shybovycha/adjika-guitar-preamp/tomato-preamp.kicad_pcb

## KiCad design tomato-preamp.kicad_pcb (2026-06-26)

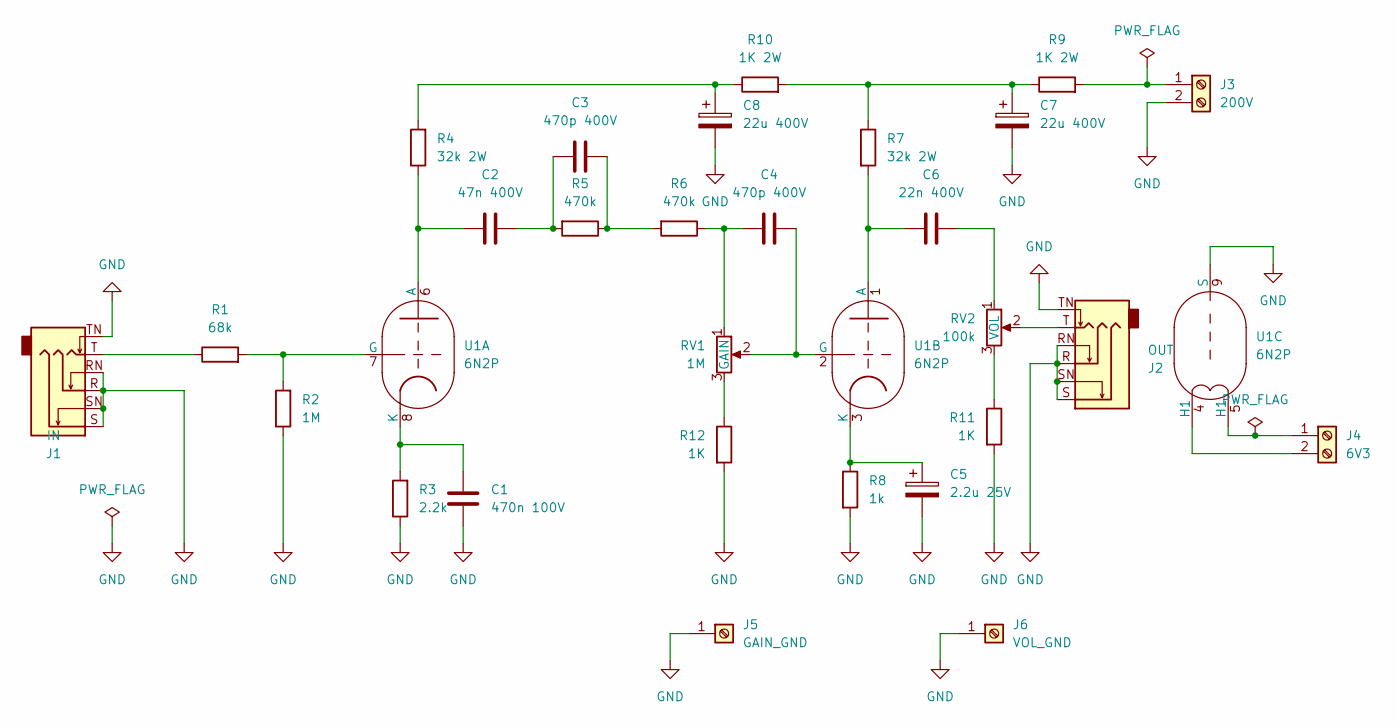
[picture p7: schematic tomato-preamp.kicad_sch, "Adjika" guitar preamp]

Parts:
C1: 470n 100V; C_Rect_L7.2mm_W5.0mm_P5.00mm
C2: 47n 400V; C_Rect_L11.0mm_W5.1mm_P10.00mm_MKT
C3, C4: 470p 400V; C_Rect_L7.0mm_W3.5mm_P5.00mm
C5: 2.2u 25V; CP_Radial_D5.0mm_P2.50mm
C6: 22n 400V; C_Rect_L11.0mm_W4.2mm_P10.00mm_MKT
C7, C8: 22u 400V; CP_Radial_D13.0mm_P5.00mm
J1: IN; Jack_6.35mm_Neutrik_NMJ6HFD2-AU_Horizontal
J2: OUT; Jack_6.35mm_Neutrik_NMJ6HFD2-AU_Horizontal
J3: 200V; SolderWire-0.75sqmm_1x02_P7mm_D1.25mm_OD3.5mm
J4: 6V3; SolderWire-0.75sqmm_1x02_P7mm_D1.25mm_OD3.5mm
J5: GAIN_GND; SolderWire-0.127sqmm_1x01_D0.48mm_OD1mm
J6: VOL_GND; SolderWire-0.127sqmm_1x01_D0.48mm_OD1mm
R1: 68k; R_Axial_DIN0207_L6.3mm_D2.5mm_P10.16mm_Horizontal
R2: 1M; R_Axial_DIN0207_L6.3mm_D2.5mm_P10.16mm_Horizontal
R3: 2.2k; R_Axial_DIN0207_L6.3mm_D2.5mm_P10.16mm_Horizontal
R4, R7: 32k 2W; R_Axial_DIN0516_L15.5mm_D5.0mm_P20.32mm_Horizontal
R5, R6: 470k; R_Axial_DIN0207_L6.3mm_D2.5mm_P10.16mm_Horizontal
R8: 1k; R_Axial_DIN0207_L6.3mm_D2.5mm_P10.16mm_Horizontal
R9, R10: 1K 2W; R_Axial_DIN0516_L15.5mm_D5.0mm_P20.32mm_Horizontal
R11, R12: 1K; R_Axial_DIN0207_L6.3mm_D2.5mm_P10.16mm_Horizontal
RV1: 1M; Potentiometer_Alps_RK163_Single_Horizontal
RV2: 100k; Potentiometer_Alps_RK163_Single_Horizontal
U1: 6N2P; Valve_6N2P-3

Connections:
GND: C1.2, C5.2, C7.2, C8.2, J1.R, J1.RN, J1.S, J1.SN, J1.TN, J2.R, J2.RN, J2.S, J2.SN, J2.TN, J3.2, J5.1 (Pin_1_1), J6.1 (Pin_1_1), R2.1, R3.1, R8.2, R11.2, R12.2, U1.9 (S)
unnamed: C2.2, C3.1, R5.2
unnamed: C3.2, R5.1, R6.2
unnamed: C4.1, R6.1, RV1.1
unnamed: C6.2, RV2.1
unnamed: C7.1, R7.1, R9.1, R10.2
unnamed: C8.1, R4.2, R10.1
unnamed: J1.T, R1.1
unnamed: J2.T, RV2.2
unnamed: J3.1, R9.2
unnamed: J4.1, U1.5 (H1)
unnamed: J4.2, U1.4 (H1)
unnamed: R11.1, RV2.3
unnamed: R12.1, RV1.3
unnamed: C2.1, R4.1, U1.6 (A)
unnamed: R1.2, R2.2, U1.7 (G)
unnamed: C1.1, R3.2, U1.8 (K)
unnamed: C6.1, R7.2, U1.1 (A)
unnamed: C4.2, RV1.2, U1.2 (G)
unnamed: C5.1, R8.1, U1.3 (K)

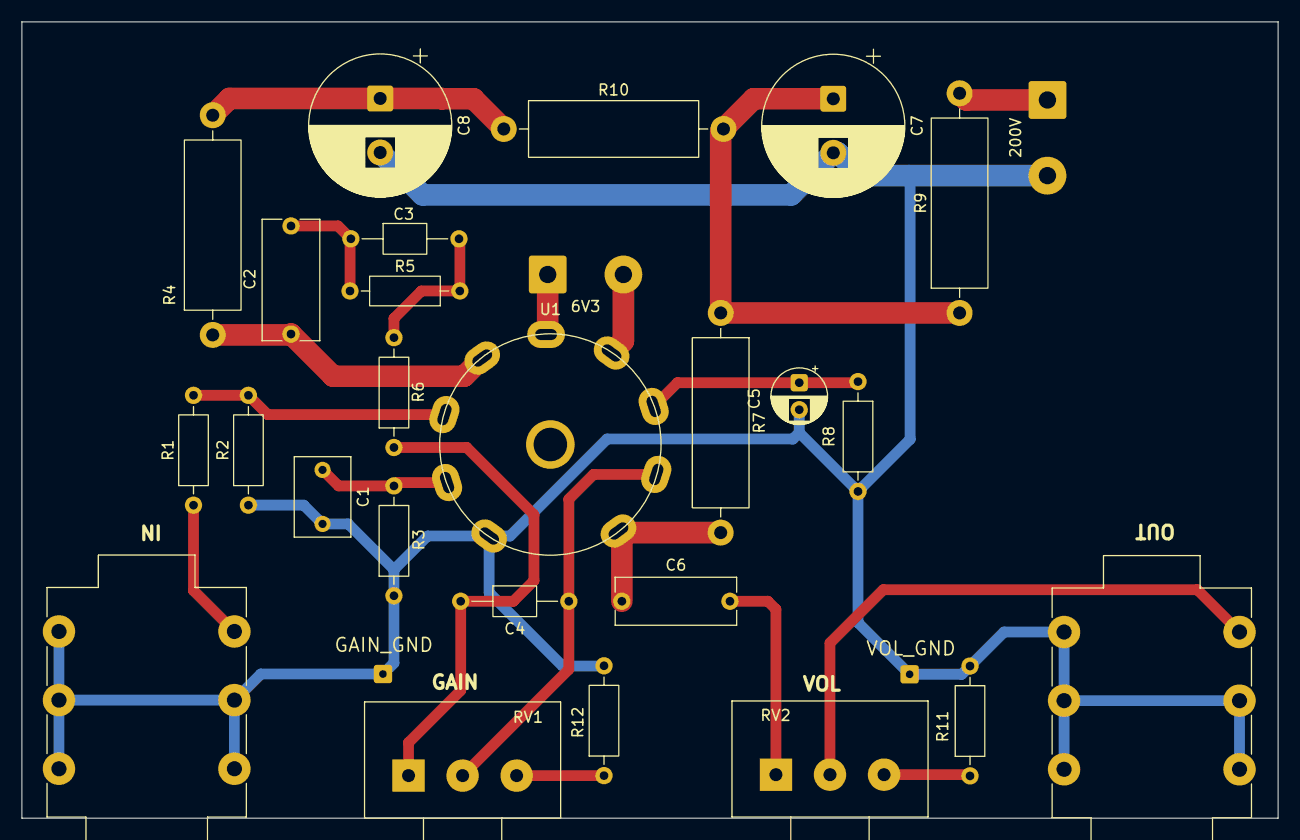
[picture p8: board tomato-preamp.kicad_pcb from above]

Board: 2 copper layers, 116.2 x 73.7 mm, 29 parts (0 on the bottom side), 20 nets.
