shybovycha/adjika-guitar-preamp/(commit log)

2026-02-13 Initial design
    [tomato-preamp.kicad_pcb, tomato-preamp.kicad_sch]
2026-02-13 single-layer version
    [tomato-preamp.kicad_pcb]
2026-02-13 moving potentiometers to the equidistant places
    [tomato-preamp.kicad_pcb]
2026-02-13 shorten the traces
    [tomato-preamp.kicad_pcb]
2026-02-13 a slightly refined board
    [tomato-preamp.kicad_pcb, tomato-preamp.kicad_sch]
2026-02-13 update CBB capacitors footprints
    [tomato-preamp.kicad_pcb, tomato-preamp.kicad_sch]
2026-02-26 Update footprints
    [tomato-preamp.kicad_pcb, tomato-preamp.kicad_sch]
2026-03-02 Add modifications to the schematic
    [tomato-preamp.kicad_sch]
